yckb1297/fpga-microwave/images/슬라이드1.JPG

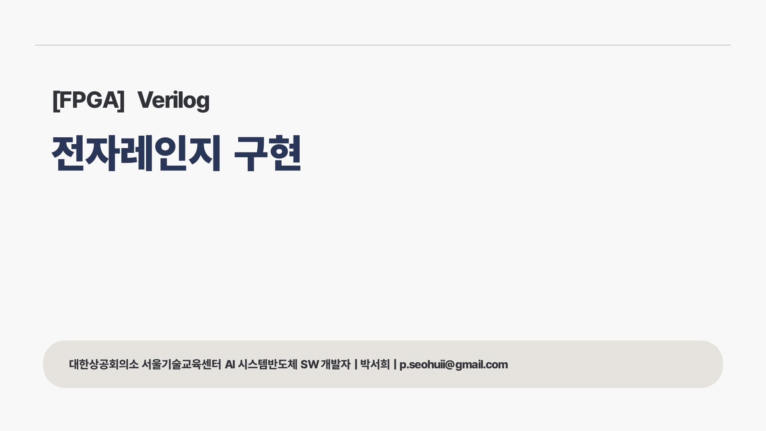
images/슬라이드1.JPG
