yckb1297/fpga-microwave/images/슬라이드2.JPG

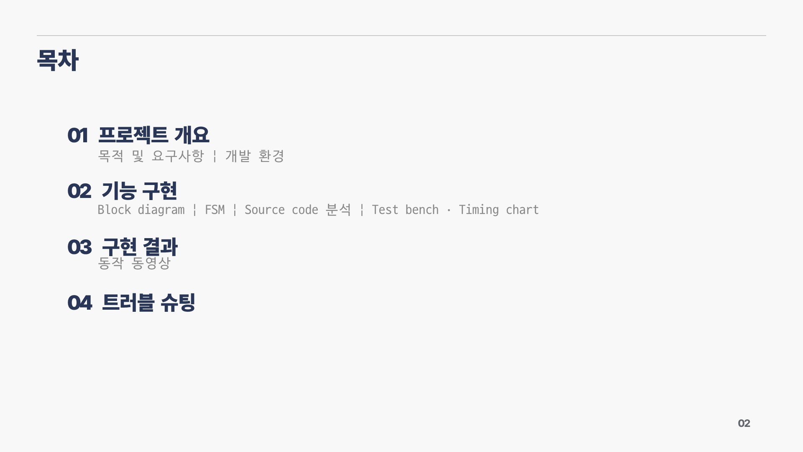
images/슬라이드2.JPG
