yckb1297/fpga-microwave/images/슬라이드6.JPG

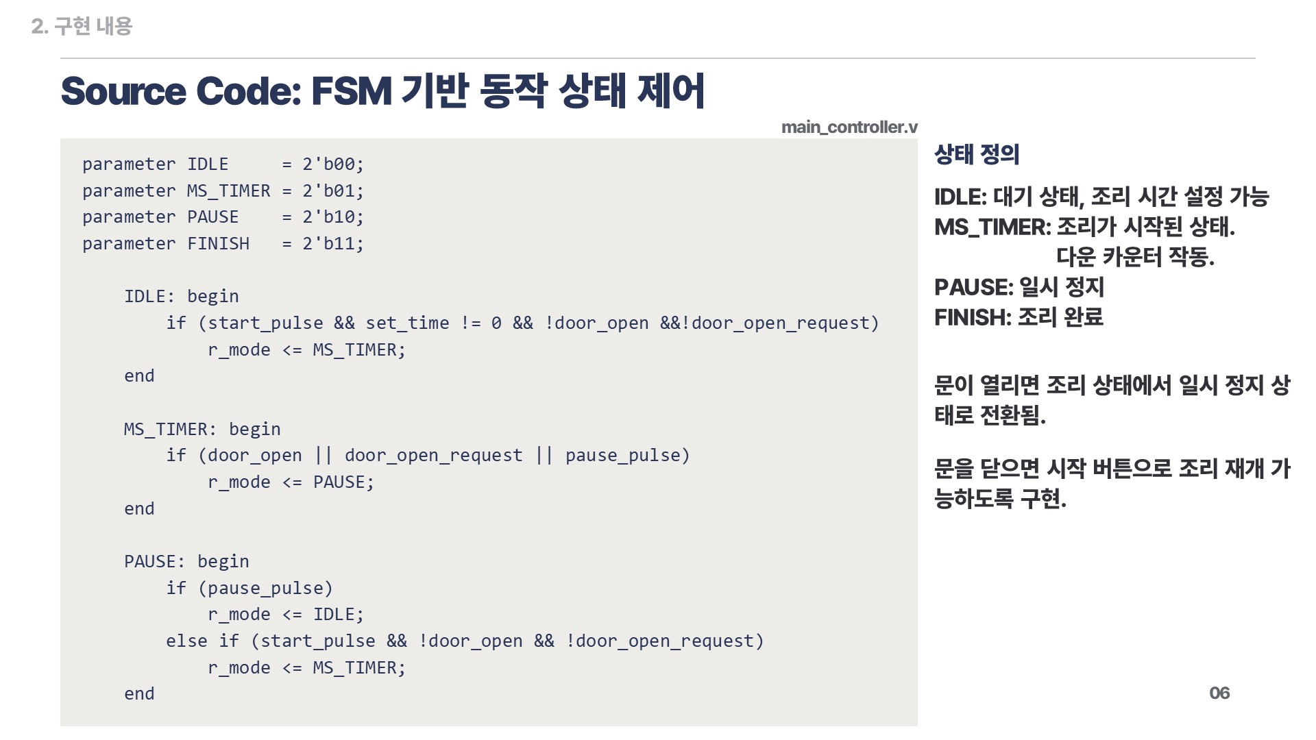
images/슬라이드6.JPG
