yckb1297/fpga-microwave/images/슬라이드7.JPG

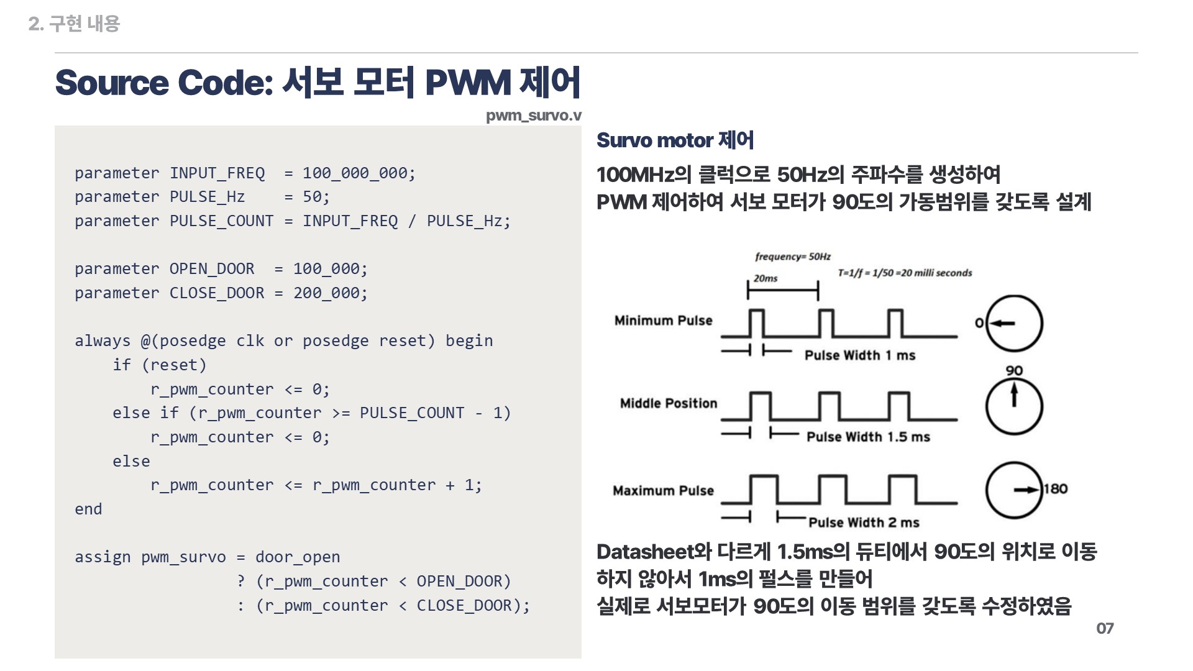
images/슬라이드7.JPG
