yckb1297/fpga-microwave/images/슬라이드8.JPG

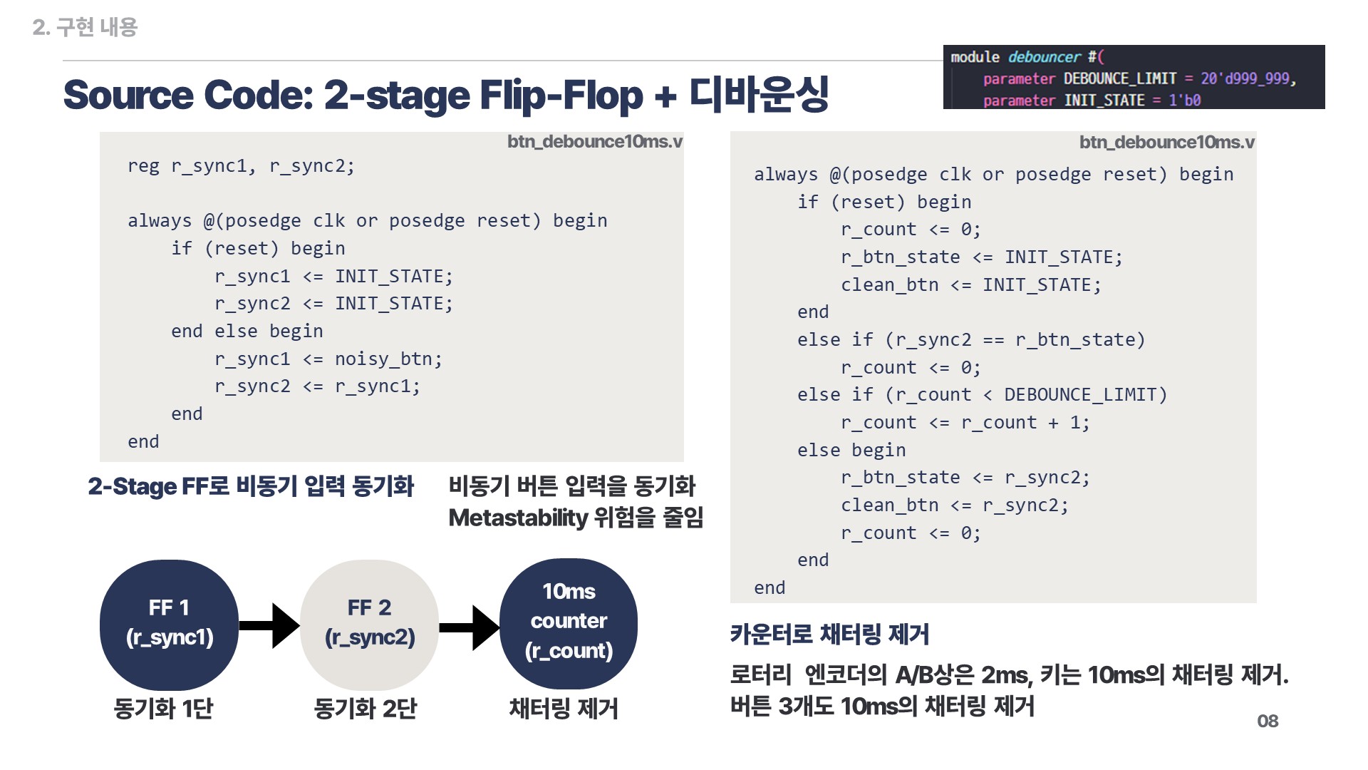
images/슬라이드8.JPG
