yckb1297/fpga-microwave/images/슬라이드9.JPG

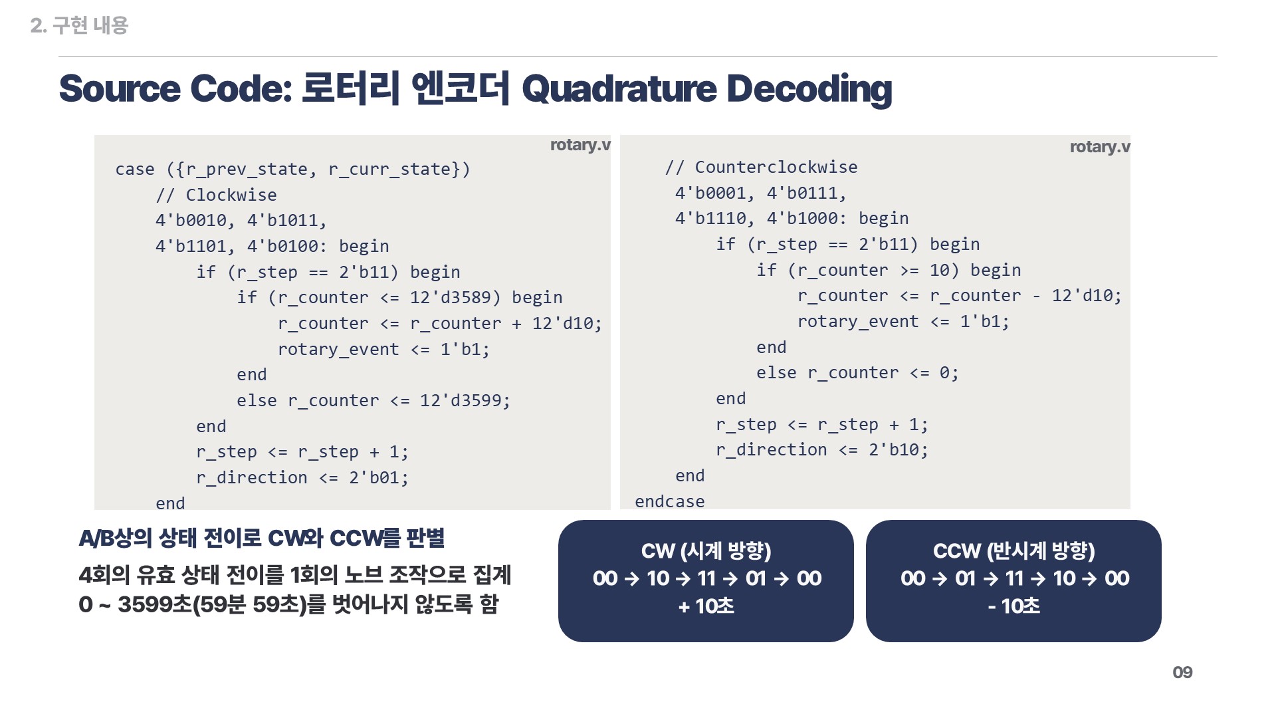
images/슬라이드9.JPG
