yckb1297/fpga-microwave/images/슬라이드10.JPG

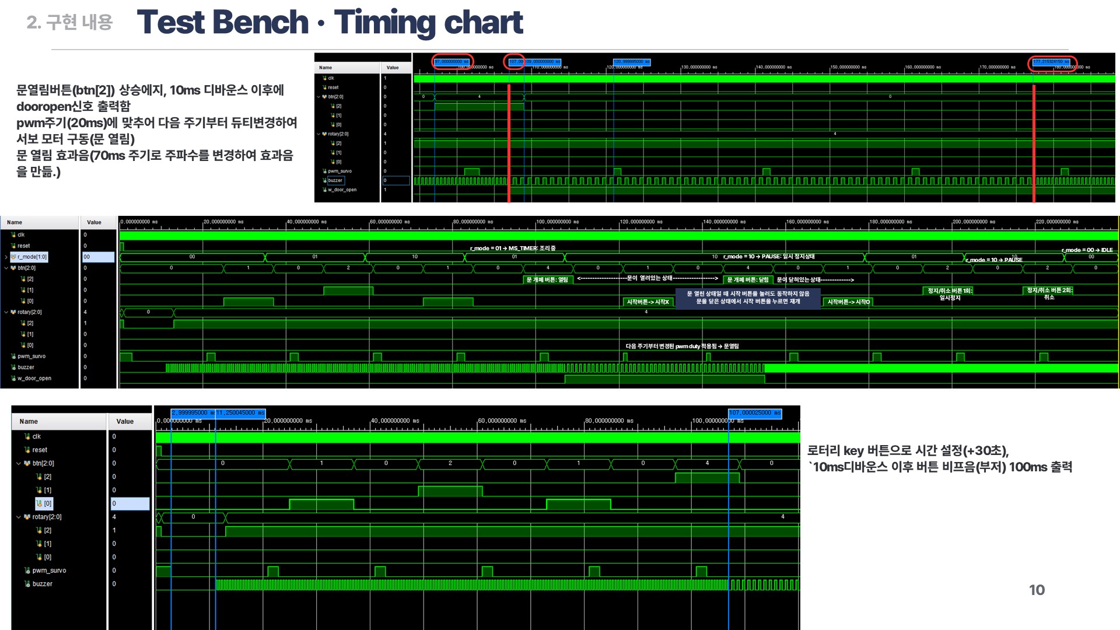
images/슬라이드10.JPG
