yckb1297/fpga-microwave/images/슬라이드11.JPG

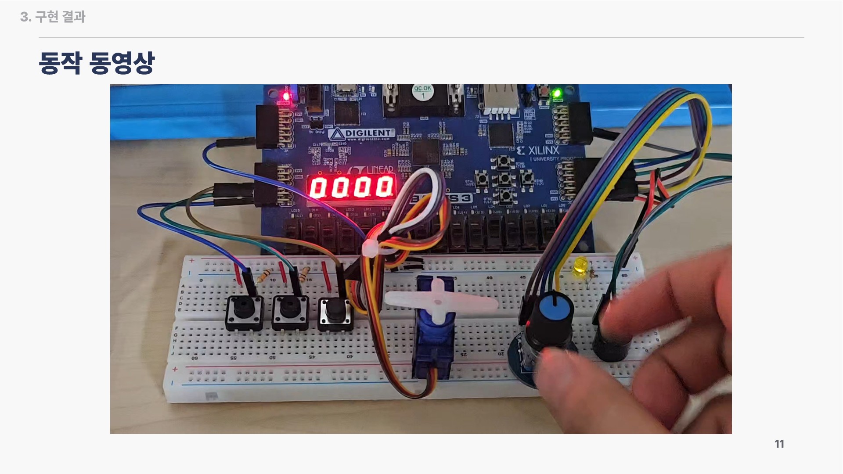
images/슬라이드11.JPG
