yckb1297/fpga-microwave/images/슬라이드12.JPG

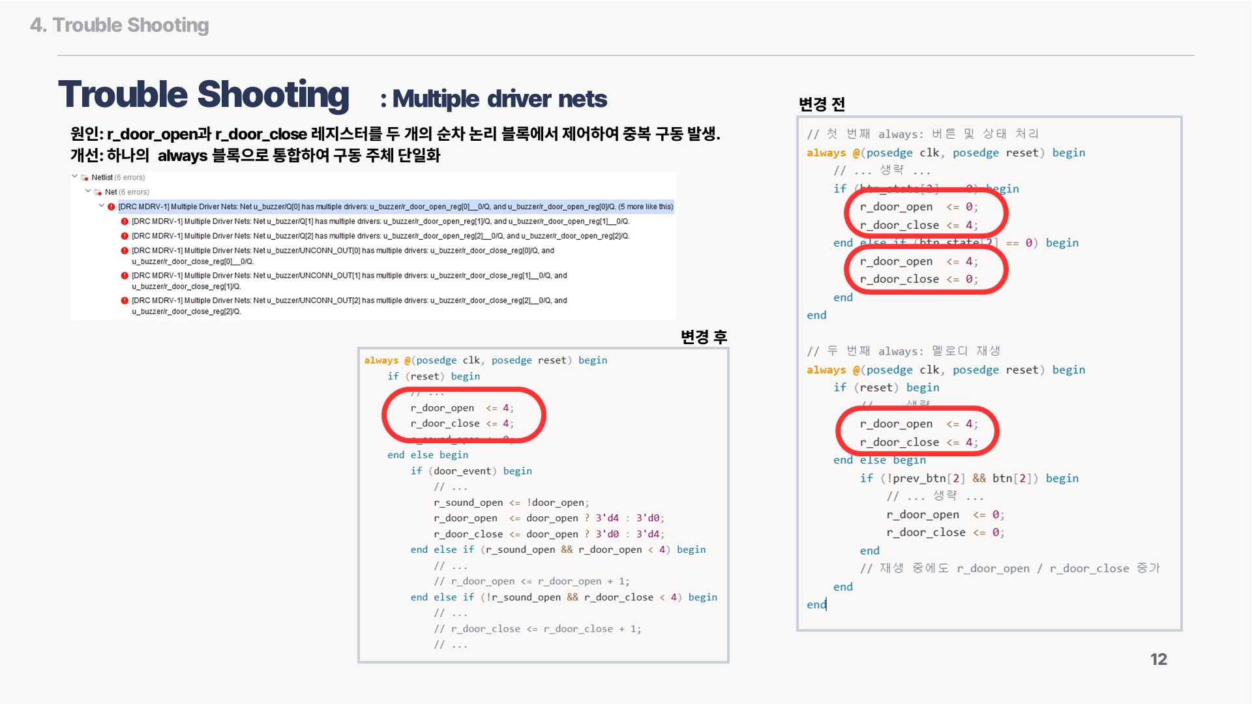
images/슬라이드12.JPG
