yckb1297/fpga-microwave/images/슬라이드13.JPG

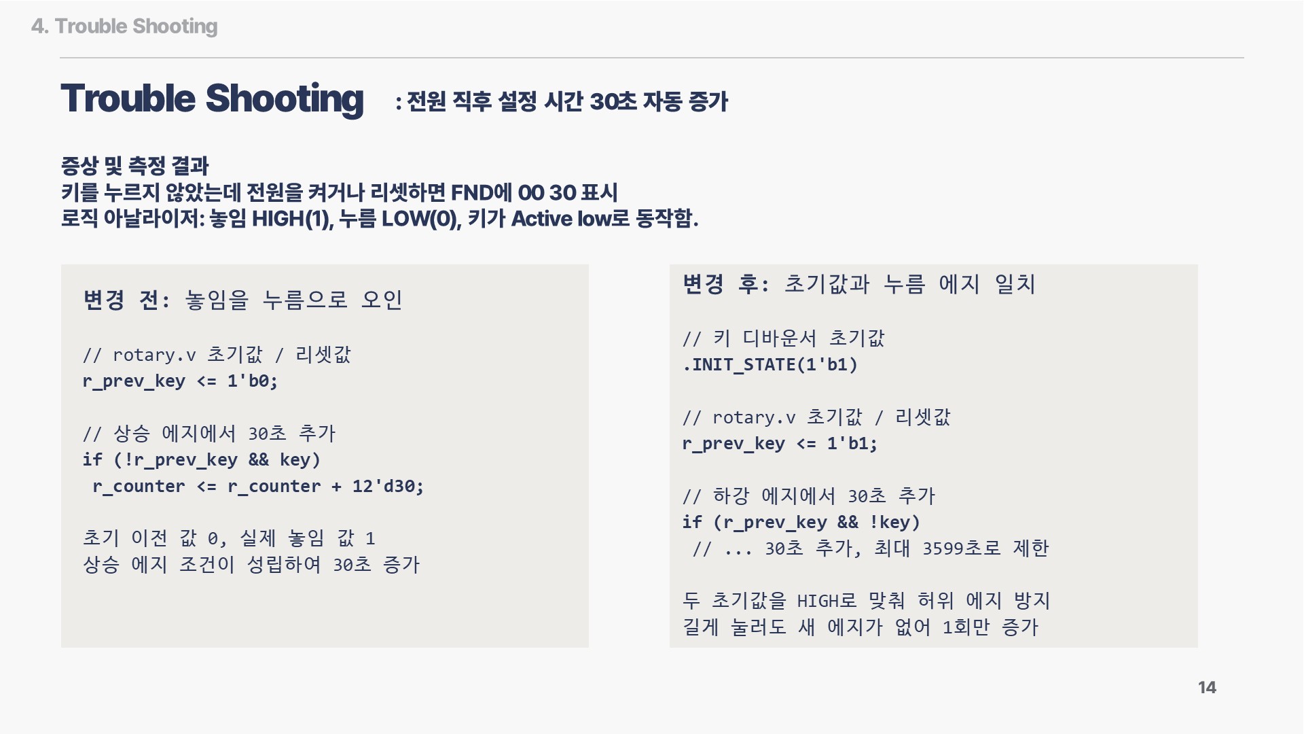
images/슬라이드13.JPG
