yckb1297/fpga-microwave/sources/tick_generator.v

`timescale 1ns / 1ps

module tick_generator(
    input clk,
    input reset,
    output reg tick
    );

    parameter INPUT_FREQ = 100_000_000;     //100MHz
    parameter TICK_Hz = 1000;   //1kHz, T=1ms
    parameter TICK_COUNT = INPUT_FREQ / TICK_Hz;    //100_000

    reg [$clog2(TICK_COUNT)-1:0] r_tick_counter = 0;

    always @(posedge clk, posedge reset) begin
        if(reset) begin
            tick <= 1'b0;
            r_tick_counter <= 0;
        end else begin
            if(r_tick_counter == TICK_COUNT-1) begin
                r_tick_counter <= 0;
                tick <= 1'b1;
            end else begin
                r_tick_counter <= r_tick_counter + 1;
                tick <= 1'b0;
            end
        end
    end
endmodule
