yckb1297/fpga-microwave/(commit log)

2026-11-01 modified button debounce module, add door_open
2026-11-11 chore: 프로젝트 폴더 정리 및 README·XDC·테스트벤치·발표 자료 추가
2026-11-11 docs: 동작 영상 링크를 유튜브로 변경
2026-11-11 style: 버튼 디바운서 설명 주석 수정
    [btn_debounce10ms.v]
